ringof/TAPRx888/TAPRX-888 Review-4.pdf

# TAPRX-888

## Table of Contents

## Design Goals:

A simplified SDR, based on the RX-888:
- Proof-of-concept design
- HF-only, no VHF converter
- Larger PCB, 6-layer
- No bottom-side components
- 0603 passive components
- Improved thermal layout
- Improved RF input filter (bypassable)
- External reference clock input, auto-switching
- Attenuated filter-bypass injector port (used for timesync)
New-888 Design Documentation | ver 3 | 1

## Block Diagram:

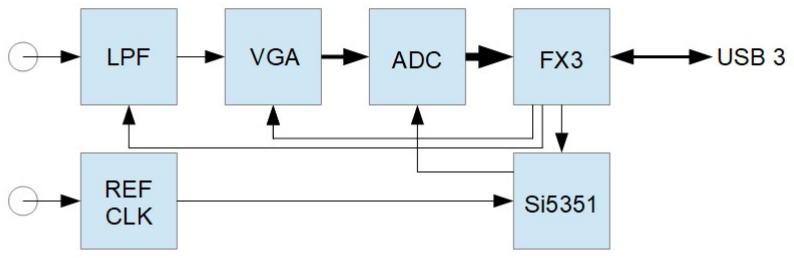
[picture p1: figure]

Block Details: (please see the accompanying schematic,

## provided in .pdf format)

Low Pass Filter
The existing RX-888 has a demonstrably poor input filter so this design includes an improved multi-section elliptical input filter combined with a high-pass shelf filter. There is a single 50 Ohm SMA input jack. While a balanced input is probably a desirable option, in the sake of simplicity I have decided to use an unbalanced design. With the shelf filter bypassed, this filter provides low-frequency response roll off at about 30 KHz.
The overall low freq cutoff is also affected by coupling caps at the VGA input and output. These can be changed in value if desired.
Some RX-888 users have requested that there be no input filtering at all, allowing them to operate in aliasing mode using external filters. To facilitate this, both the shelf and the low-pass filters can be bypassed using header-pin jumpers.
There is an SMA input jack that feeds the output of the filters with an attenuated signal. This can be used as a time-sync input.

Variable Gain Amplifier
The existing RX-888 has a coupling transformer that provides a balanced input to the VGA, and provides a 1:2 impedance step-up to match the filter to the 200 Ohm amplifier input impedance. The existing RX-888 also includes a variable attenuator and RF source multiplexers. In order to provide extended low frequency response, the new design eliminates these multiplexers and the transformer, instead driving the amplifier from a single-ended 50 Ohm source. This will reduce the overall gain, but elimination of the multiplexers will partially mitigate this.

Analog to Digital Converter
The board is designed to use the LTC2208 16-bit ADC (as is used in the RX-888), but the pin-compatible 14-bit variant can be used instead.
The analog input is provided by the differential output of the VGA, with minimal filtering.
The sample clock is provided by the Si5351 clock generator followed by a differential output buffer A future option to explore is to invert one of the unused outputs of the Si5351 to create a differential clock. Very accurate phase-control is available in this mode.

Clocks

Reference Clock Input
While the RX-888 typically uses a 27 MHz reference clock (and this is the fall-back frequency provided by the internal TCXO), in some cases a different frequency is used. The reference clock input allows virtually any frequency to be used.
This is a well-protected and properly-terminated clock input circuit, accepting a sine or square-wave input from 10 to 30 MHz (the reasonable limits of the internal Si5351 clock generator), with an amplitude range between -20 to +20 dBm. A clock-presence detector circuit automatically switches between the internal 27 MHz TCXO and the external clock. The clock detector status is available to be read by the FX3 firmware.
The clock-switching section may be modified to allow software control as well as automatic operation. A clock-status LED will probably be added.

Si5351 Clock Generator
(see “Analog to Digital Converter” for details)

FX3 USB Interface
AKA U9, the CYUSB3014
Much of the connections to this chip are based on Franco's extremely helpful email, excerpted below:

Also my repo for the FX3 firmware is just a copy of the original repo that Oscar Steila started and now Howard sort of maintains (his last commit was about six months ago): https://github.com/ik1xpv/ExtIO_sddc

Anyway the connections between the FX3 and the other peripherals are described in the so called IOMatrix: https://github.com/ik1xpv/ExtIO_sddc/blob/master/SDDC_FX3/StartUP.c#L63-L78

Translating that to English, it means that the FX3 uses:
- the UART port
- the I2C port
- the GPIF II interface in 16-bit mode (since that's how it pulls the samples the LTC2208)
- several GPIO pins (see below)
- the 'Low Performance Peripherals' (lpp) mode is set to CY_U3P_IO_MATRIX_LPP_UART_ONLY

With this information the next step is to look at datasheet of the FX3 (https://www.infineon.com/assets/row/public/documents/24/49/infineon-cyusb301x-cyusb201x-ez-usb-fx3-superspeed-usb-controller-datasheet-en.pdf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) (https://www.infineon.com/assets/row/public/documents/24/49/infineon-cyusb301x-cyusb201x-ez-usb-fx3-superspeed-usb-controller-datasheet-en.pdf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) on pages 28-31 where they have the pin description.
The column for 'CY_U3P_IO_MATRIX_LPP_UART_ONLY' is the one labelled '16-bit DataBus + UART + GPIO', which means that:
- UART uses pins D4, C1, C2, and D5
- I2C uses pins D9, and D10
- GPIF II (i.e. the LTC2208) uses pins F10, F9, F7, G10, G9, F8, H10, H9, J10, J9, K11, L10, K10, K9, J8, and G8
- the clock from the LTC2208 that is used to drive the GPIF II state machine is PCLK, which is on pin J6

As I mentioned above, there are also several GPIO pins being used in the RX888-mkII (https://github.com/ik1xpv/ExtIO_sddc/blob/master/SDDC_FX3/radio/rx888r2.c#L4-L15):

- GPIO_ATT_LE GPIO17 -> pin K8
- GPIO_BIAS_VHF GPIO18 -> pin K7
- GPIO_BIAS_HF GPIO19 -> pin J7
- GPIO_RANDO GPIO20 -> pin H7
- GPIO_LED_RED GPIO21 -> pin G7
- GPIO_PGA GPIO24 -> pin H8
- GPIO_ATT_DATA GPIO26 -> pin H6
- GPIO_ATT_CLK GPIO27 -> pin K5
- GPIO_SHDWN | GPIO28 -> pin J5
- GPIO_DITH | GPIO29 -> pin H5

- GPIO_VHF_EN GPIO35 -> pin K1
- GPIO_VGA_LE GPIO38 -> pin J1

GPIO[15:0]: connected to ADC DA[15:0]. While series resistors have been used on some versions of the “888” I believe that these were only necessary when the FX3 evaluation board was used. In the current design these traces are short and direct.
GPIO[16]: ADC CLKOUTA
GPIO[17]: external reference clock present (active high)
GPIO[35]: external clock select (active high) – previously used for GPIO_VHF_EN GPIO[37]: external clock auto-select (active low, remove R49 to force auto-select) GPIO[20]: ADC RAND (input to ADC)
GPIO[25]: ADC OVFL
GPIO[26]: VGA D (gain control data input to VGA)
GPIO[27]: VGA CLK
GPIO[38]: VGA Latch Enable
GPIO[29]:ADC Dither (probably not used)
GPIO[30]: PMODE[0] (selects USB boot mode, 0 Ohm pullup)
GPIO[31]: PMODE[1] (selects USB boot mode, 0 Ohm pullup)
GPIO[32]: PMODE[2] (selects USB boot mode, not connected resistor pullup) GPIO[33]: ID[0] 1K pulldown
GPIO[36]: ID[1] 1K pulldown
GPIO[45]: ID[2] 1K pulldown
GPIO[50]: ID[3] 1K pulldown
GPIO[51]: ID[4] 1K pulldown
GPIO[52]: ID[5] 1K LED pullup (blue, active low)
GPIO[53]: ID[6] 1K LED pullup (green, active low)
GPIO[54]: ID[7] 1K LED pullup (red, active low)
- Pad C5 is the RESET_N input, currently connected to a simple RC pullup and puchbutton. In a future revision this may be changed to a slower and more reliable erset circuit.
- Pad C6 (XTALIN) is being driven by a 19.2 MHz oscillator, rather than with a crystal and load capacitors. This is done to avoid potential crystal and tuning issues. This may be changed in a future revision.

- The ID[7:0] nets are used to identify the TAPRX-888 board to the FX3 firmwareFrom “ExtIO_sddc-master:”

HWSDRtable.h v1.2
Hardware detection of BBRF103 family SDRs
+--------------+-------+------+------+------+------+------+------+------+------+----------------------------+
| SDR | | MODEL | GPIO | GPIO | GPIO | GPIO | GPIO | GPIO | GPIO | GPIO | USED BY | |
| | | # | | 33 | | 36 | | 45 | | 50 | | 51 | | 52 | | 53 | | 54 | | | |
+--------------+-------+------+------+------+------+------+------+------+------+----------------------------+
| BBRF103 | | 0x01 | | - | | - | | - | pd* | | - | | - | | - | LED | Oscar Steila | |
+--------------+-------+------+------+------+------+------+------+------+------+----------------------------+
| HF103 | | 0x02 | | - | | - | | - | | - | pd* | | - | | - | LED | Oscar Steila | |
+--------------+-------+------+------+------+------+------+------+------+------+----------------------------+
| RX888 | | 0x03 | | - | | - | pd | | - | | - | | - | | - | | - | Justin Peng / Howard Su | |
+--------------+-------+------+------+------+------+------+------+------+------+----------------------------+
| RX888 r2 | | 0x04 | | - | pd | | - | | - | | - | | - | | - | | - | Justin Peng / Howard Su | |
+--------------+-------+------+------+------+------+------+------+------+------+----------------------------+
| RX999 | | 0x05 | pd | | - | | - | | - | | - | | - | | - | | - | Justin Peng / Howard Su | |
+--------------+-------+------+------+------+------+------+------+------+------+----------------------------+
| LUCY | | 0x06 | | - | | - | | - | | - | | - | pd+ | pd+ | | - | Wiktor Starzak | |
+--------------+-------+------+------+------+------+------+------+------+------+----------------------------+
| --- | | - | | | - | | - | | - | pd | pd | pd | pd | LED | Oscar Steila | |
+--------------+-------+------+------+------+------+------+------+------+------+----------------------------+
| SDR-HF | | - | | | - | | - | | - | pu | pd | pd | pd | LED | Pieter Ibelings | |
+--------------+-------+------+------+------+------+------+------+------+------+----------------------------+
+--------------+-------+------+------+------+------+------+------+------+------+----------------------------+

Power Supply
The board is powered from the USB-3 port, drawing approximately 1A at 5V.
There are three principal regulated voltage domains: 1.25V for the FX3 core, 3.3V for the FX3 I/O, and 3.3V for the ADC. In addition, the VGA and the clock section each have 3.3V supplied by individual regulators.
The FX3 and ADC 3.3V sources are fed by individual regulators, but the regulator outputs are clamped together by two Schottky diodes to ensure that these outputs start up together. A single regulator can provide the initial current, but dual regulators are used to distribute the thermal dissipation.
The 1.25V regulator is connected to a 3.3V pre-regulator, again to distribute the thermal dissipation.

Regulator Power Dissipation

3V3REF

Device | Current | Regulator Dissipation (5V – 3.3V) * I
Clock Block | 60 mA | 102 mW

VGA3.3V

Device | Current | Regulator Dissipation (5V – 3.3V) * I
AD8370 VGA | 100 mA | 170 mW

+3V3ADC

Device | Current | Regulator Dissipation (5V – 3.3V) * I
LTC2208 ADC Ivdd | 100 mA | 170 mW
LTC2208 ADC IOvdd | 450 mA | 765 mW
total | 550 mA | 935 mW

+3V3

Device | Current | Regulator Dissipation (5V – 3.3V) * I
U8 19.2MHz XO | 5 mA | 9 mW
U9 CYUSB3014 IO | 10 mA ? | 17 mW
total | 15 mA ? | 26 mW

+1V2

Device | Current | Power
U9 CYUSB3014 core | 200 mA
U9 CYUSB3014 USB | 60 mA
total | 260 mA | Regulator Dissipation
Pre-regulator (3.3V) | | 442 mW
Post-regulator (1.25V) | | 533 mW

Total board power: 985mA x 5V = approximately 5W

## Layout

This is a six-layer board, with all components on the top. The board is 76mm wide, 100mm long. The layers are:
Top | Signal and power traces
2 | Ground
3 | Power planes
4 | Signal + ground + 1.2V Power
5 | Ground
Bottom | Signal + ground

Top

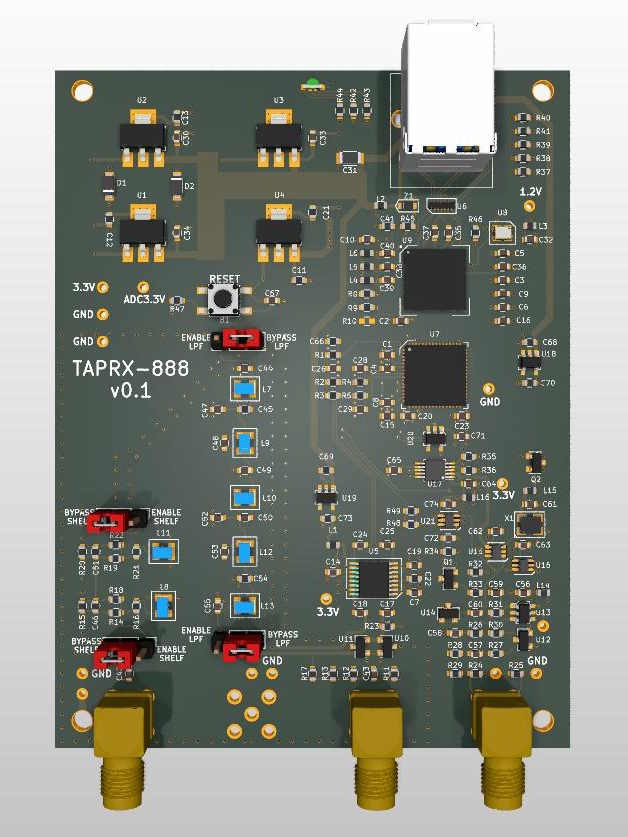
[picture p2: figure]

Bottom
The components with significant thermal dissipation have copper zones on all layers, interconnected by thermal vias. The bottom-side solder-mask is absent around these zones, allowing for the use of a thermal pad to transfer the heat to the aluminum enclosure. The four un-masked areas underneath the voltage regulators are electrically connected to the various positive regulator outputs, while the areas under the VGA and the ADC are at ground potential.

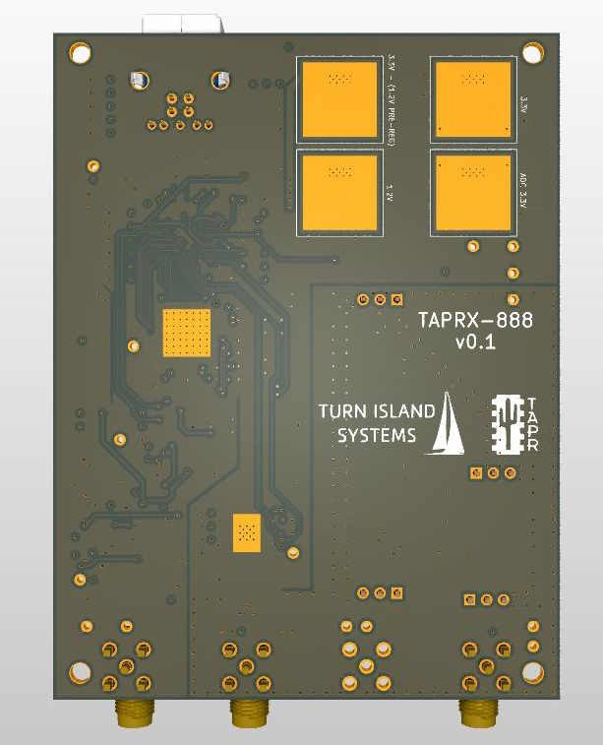
[picture p3: figure]

Ground Planes
The ground and power planes have isolation gaps (seen here on the layer-2 groundplane) that are intended to reduce ground-path current induced inter-stage coupling.

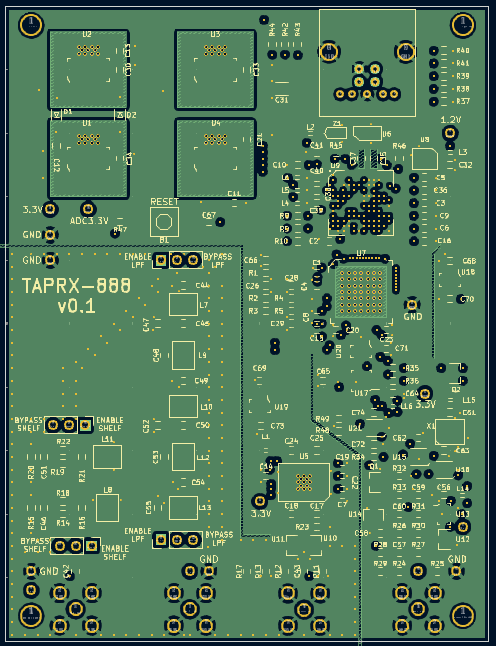
[picture p4: figure]

Power Plane

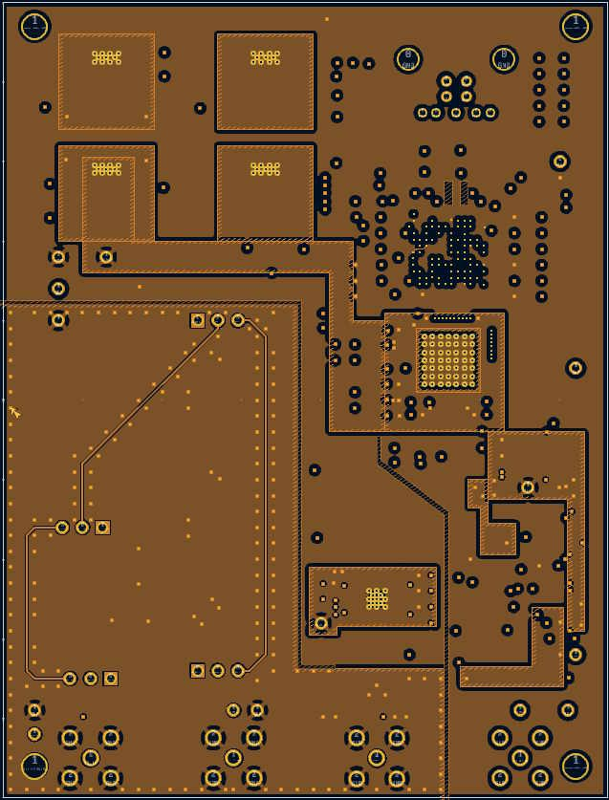
[picture p5: figure]

The layer 3 power plane distributes the various +3.3V supplies, with some isolated sections that provide additional filtering.
In the area of the RF input filters this layer is used as additional groundplane and signal routing. The +1.2V supply is distributed on layer 4.

## Cost

This is just a rough estimate, not to be trusted.

JLCPCB fab/assy, qty 5

Missing parts, +$177:

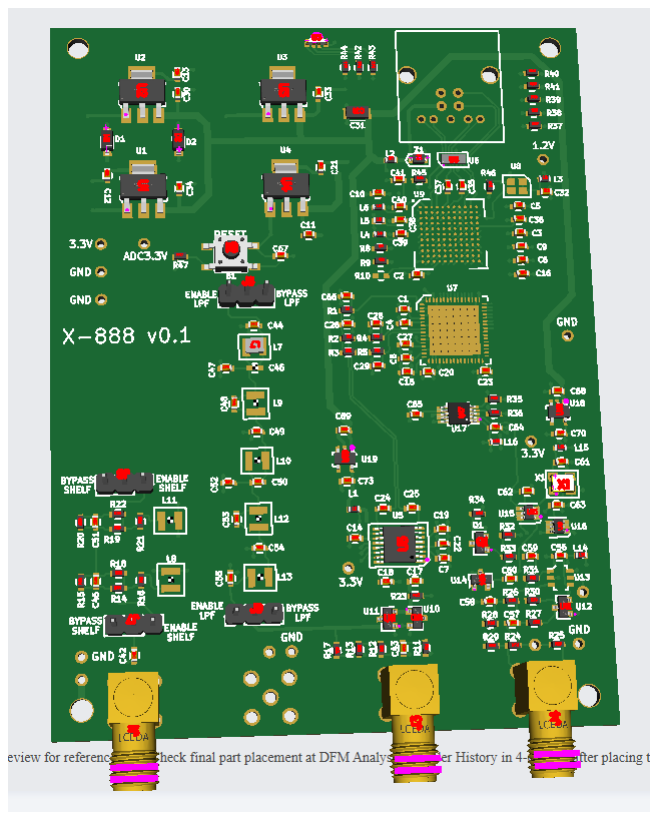
[picture p6: figure]
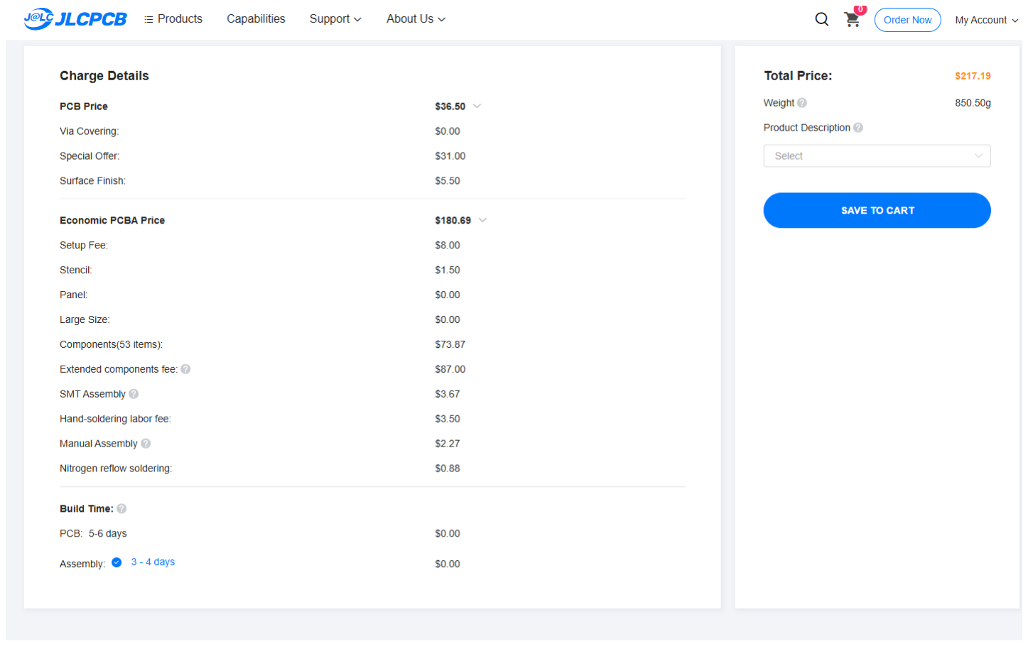
[picture p7: figure]

LTC2208 ADC: $150 (qty 10, Mouser) – 14-bit parts cost about the same CYUSB3014-BZXCT: $25 (qty 10, DigiKey)
TLV3501 (comparator): $1.20 (qty 10, LCSC)
USB-306BWD-ARW (USB 3.0 connector): $0.41 (qty 10, LCSC)

Oscillator-19.2MHz: $0.33 (qty 10, LCSC)

JLC fab+assy cost, plus missing parts = approx $400 add:
12% sales tax: $48
50% customs / tariff: $200
Shipping: $150

Total: $798
About $160 per board, probably more.

The enclosure I use costs about $7 (including custom PCB faceplates). External heatsink: $?
Thermal pad: $?
Testing: $?
