ringof/TAPRx888/TAPRX-888.kicad_pcb

## KiCad design TAPRX-888.kicad_pcb (2026-07-15)

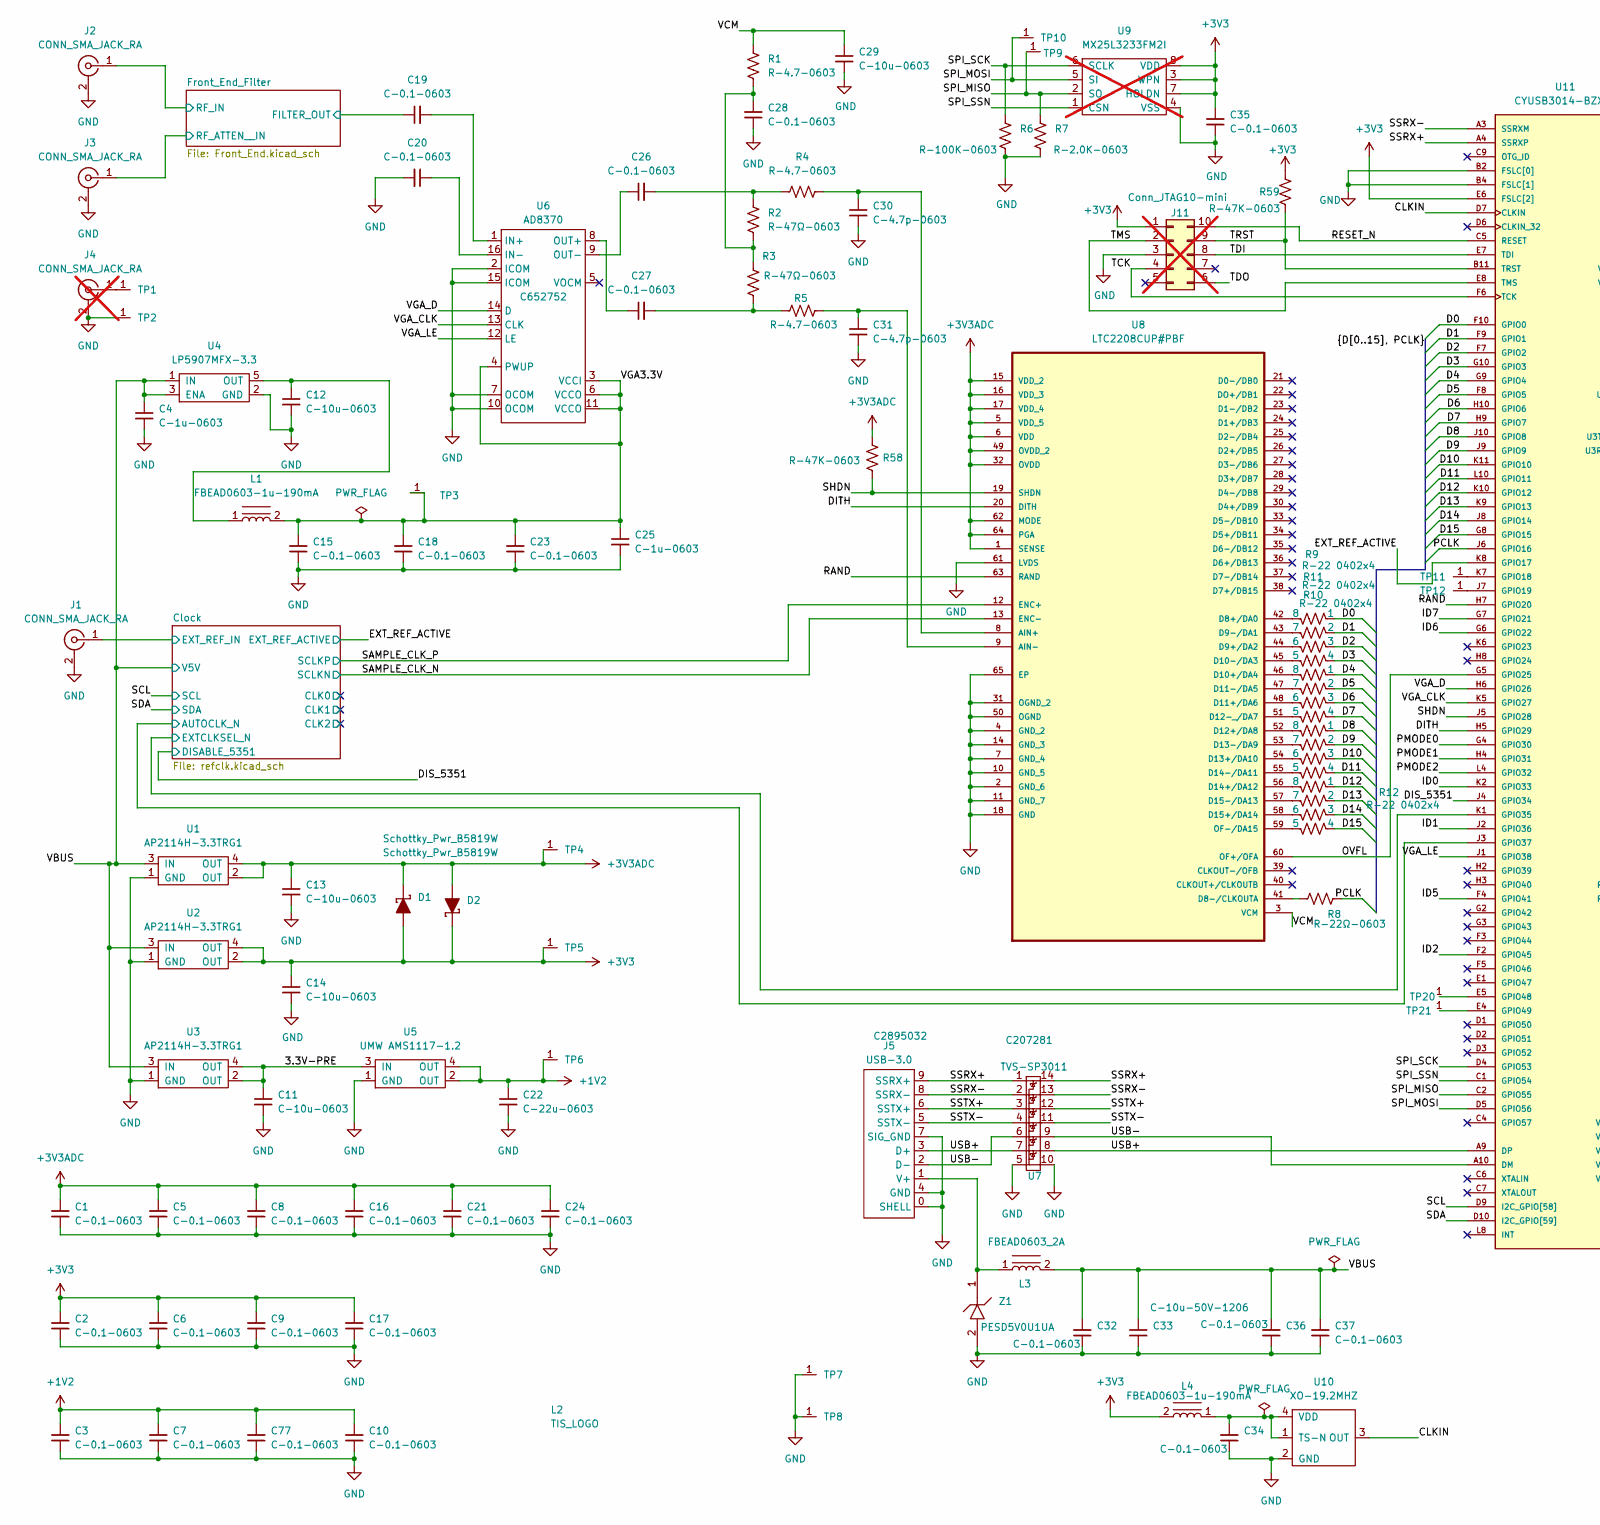
[picture p8: schematic TAPRX-888.kicad_sch, part in row 1, column 1]

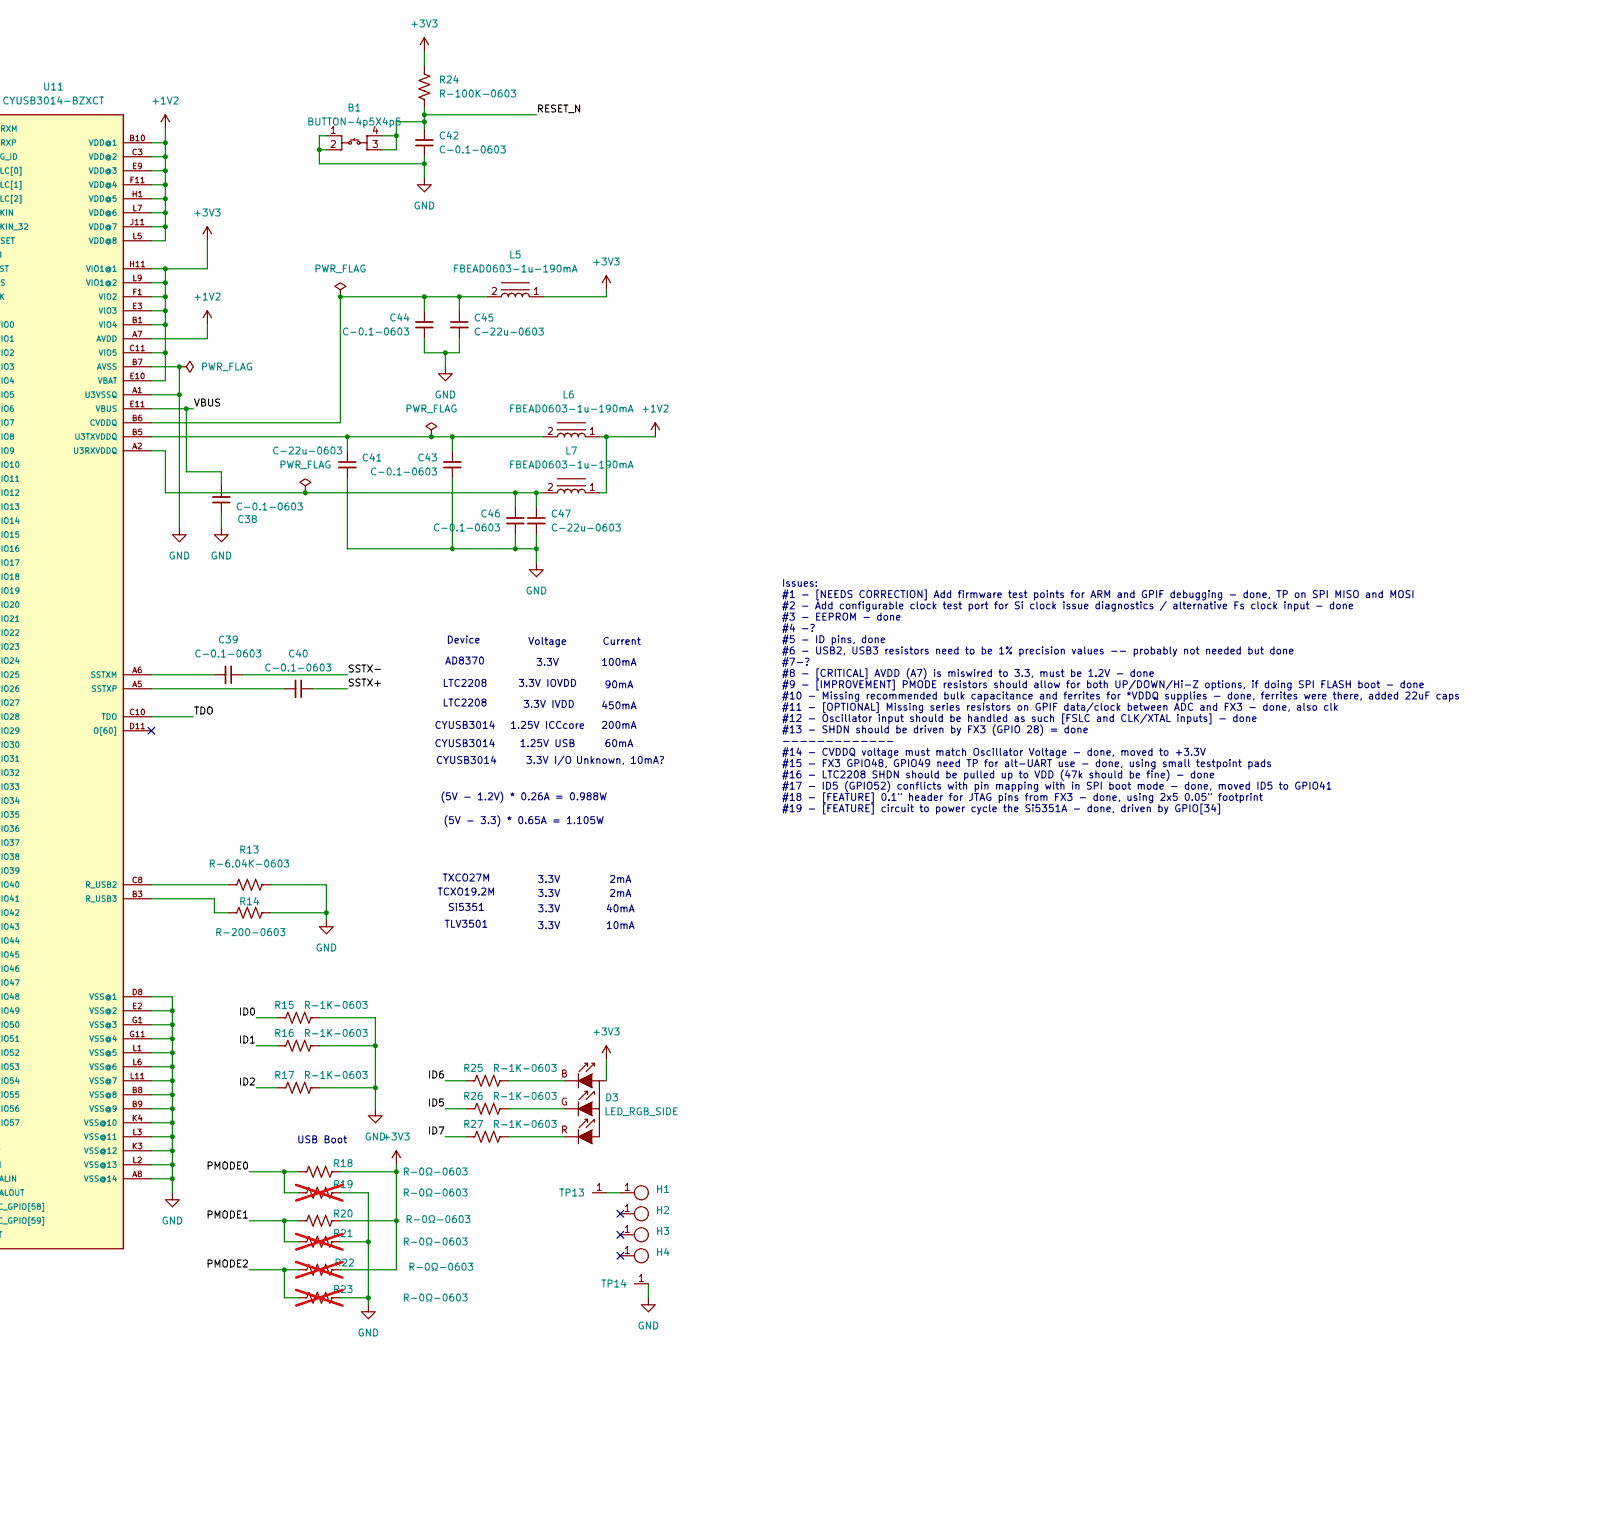
[picture p9: schematic TAPRX-888.kicad_sch, part in row 1, column 2]

Parts:
B1: BUTTON-4p5X4p5; LCSC Part # C410371
C1, C2, C3, C5, C6, C7, C8, C9, C10, C15, C16, C17, C18, C19, C20, C21, C23, C24, C26, C27, C28, C32, C34, C35, C36, C37, C38, C39, C40, C42, C43, C44, C46, C77: C-0.1-0603; C_0603; LCSC Part # C14663
C4, C25: C-1u-0603; PAD_0603; LCSC Part # C15849
C11, C12, C13, C14, C29: C-10u-0603; PAD_0603; LCSC Part # C96446
C22, C41, C45, C47: C-22u-0603; PAD_0603; LCSC Part # C59461
C30, C31: C-4.7p-0603; C_0603; LCSC Part # C1669
C33: C-10u-50V-1206; PAD_1206; LCSC Part # C13585
D1, D2: Schottky_Pwr_B5819W; SOD-123; LCSC Part # C8598
D3: LED_RGB_SIDE; LCSC Part # C389528
H1, H2, H3, H4: MountingHole_M2.5-PTH
J1, J2, J3: CONN_SMA_JACK_RA; SMA-RA-Jack; LCSC Part # C91455
J4: CONN_SMA_JACK_RA; SMA-RA-Jack; LCSC Part # C91455; not fitted
J5: USB-3.0; LCSC Part # C2895032
J11: Conn_JTAG10-mini; CONN-JTAG10-mini; LCSC Part # Cxxxxxx; not fitted
L1, L4, L5, L6, L7: FBEAD0603-1u-190mA; 0603; LCSC Part # C307748
L2: TIS_LOGO; TIS-Logo
L3: FBEAD0603_2A; 0603; LCSC Part # C14709
R1, R4, R5: R-4.7-0603; PAD_0603; LCSC Part # C23164
R2, R3: R-47Ω-0603; PAD_0603; LCSC Part # C23179
R6, R24: R-100K-0603; PAD_0603; LCSC Part # C25803
R7: R-2.0K-0603; PAD_0603; LCSC Part # C22975
R8: R-22Ω-0603; PAD_0603; LCSC Part # C23345
R9, R10, R11, R12: R-22 0402x4; 4D02; LCSC Part # C25499
R13: R-6.04K-0603; PAD_0603; LCSC Part # C25977
R14: R-200-0603; PAD_0603; LCSC Part # C8218
R15, R16, R17, R25, R26, R27: R-1K-0603; PAD_0603; LCSC Part # C21190
R18, R20: R-0Ω-0603; PAD_0603; LCSC Part # C21189
R19, R21, R22, R23: R-0Ω-0603; PAD_0603; LCSC Part # C21189; not fitted
R58, R59: R-47K-0603; PAD_0603; LCSC Part # C25819
TP1, TP2, TP3, TP4, TP5, TP6, TP7, TP8, TP9, TP10, TP11, TP12, TP13, TP14: TP
TP20, TP21: TP-TINY; TP-Tiny
U1, U2, U3: AP2114H-3.3TRG1; SOT-223_THERMAL; LCSC Part # C150716
U4: LP5907MFX-3.3; SOT-23-5; LCSC Part # C80670
U5: UMW AMS1117-1.2; SOT-223_THERMAL; LCSC Part # C347218
U6: AD8370; TSSOP-16-Thermal; LCSC Part # C652752
U7: TVS-SP3011; SP3011; LCSC Part # C207281
U8: LTC2208CUP#PBF; QFN-64_EP_9.5x9.5_Pitch0.5mm; MPN LTC2208CUP#PBF#PBF; LCSC Part # C7458386
U9: MX25L3233FM2I; SOIC-8-dual; LCSC Part # C190802; not fitted
U10: XO-19.2MHZ; SMD-2520; LCSC Part # C49304731
U11: CYUSB3014-BZXCT; BGA-121; DigiKey_Part_Number 448-CYUSB3014-BZXCTTR-ND
Z1: PESD5V0U1UA; SOD-323; LCSC Part # C5380401

Connections:
+1V2: C3.2, C7.2, C10.2, C22.1, C77.2, L6.1, L7.1, TP6.1, U5.2 (OUT), U5.4 (OUT), U11.A7 (AVDD), U11.B10 (VDD@1), U11.C3 (VDD@2), U11.E9 (VDD@3), U11.F11 (VDD@4), U11.H1 (VDD@5), U11.J11 (VDD@7), U11.L5 (VDD@8), U11.L7 (VDD@6)
+3V3: C2.2, C6.2, C9.2, C14.1, C17.2, C35.2, D1.2 (A), D2.1 (K), D3.1 (C), J11.1, L4.2, L5.1, R18.2, R20.2, R22.2, R24.1, R59.1, TP5.1, U2.2 (OUT), U2.4 (OUT), U9.3 (WPN), U9.7 (HOLDN), U9.8 (VDD), U11.B1 (VIO4), U11.C11 (VIO5), U11.E3 (VIO3), U11.E6 (FSLC[2]), U11.E10 (VBAT), U11.F1 (VIO2), U11.H11 (VIO1@1), U11.L9 (VIO1@2); also elsewhere on the board
+3V3ADC: C1.2, C5.2, C8.2, C13.1, C16.2, C21.2, C24.2, D1.1 (K), D2.2 (A), R58.1, TP4.1, U1.2 (OUT), U1.4 (OUT), U8.1 (SENSE), U8.5 (VDD_5), U8.6 (VDD), U8.15 (VDD_2), U8.16 (VDD_3), U8.17 (VDD_4), U8.32 (OVDD), U8.49 (OVDD_2), U8.62 (MODE), U8.64 (PGA)
/3.3V-PRE: C11.1, U3.2 (OUT), U3.4 (OUT), U5.3 (IN)
/CLKIN: U10.3 (OUT), U11.D7 (CLKIN)
/Clock/AUTOCLK_N: U11.J3 (GPIO37); also elsewhere on the board
/Clock/EXTCLKSEL_N: U11.K1 (GPIO35); also elsewhere on the board
/Clock/EXT_REF_IN: J1.1 (In); also elsewhere on the board
/D0: R9.1, U11.F10 (GPIO0)
/D1: R9.2, U11.F9 (GPIO1)
/D2: R9.3, U11.F7 (GPIO2)
/D3: R9.4, U11.G10 (GPIO3)
/D4: R10.1, U11.G9 (GPIO4)
/D5: R10.2, U11.F8 (GPIO5)
/D6: R10.3, U11.H10 (GPIO6)
/D7: R10.4, U11.H9 (GPIO7)
/D8: R11.1, U11.J10 (GPIO8)
/D9: R11.2, U11.J9 (GPIO9)
/D10: R11.3, U11.K11 (GPIO10)
/D11: R11.4, U11.L10 (GPIO11)
/D12: R12.1, U11.K10 (GPIO12)
/D13: R12.2, U11.K9 (GPIO13)
/D14: R12.3, U11.J8 (GPIO14)
/D15: R12.4, U11.G8 (GPIO15)
/DIS_5351: U11.J4 (GPIO34); also elsewhere on the board
/DITH: U8.20 (DITH), U11.H5 (GPIO29)
/EXT_REF_ACTIVE: U11.K8 (GPIO17); also elsewhere on the board
/Front_End_Filter/FILTER_OUT: C19.1; also elsewhere on the board
/Front_End_Filter/RF_ATTEN__IN: J3.1 (In); also elsewhere on the board
/Front_End_Filter/RF_IN: J2.1 (In); also elsewhere on the board
/ID0: R15.1, U11.K2 (GPIO33)
/ID1: R16.1, U11.J2 (GPIO36)
/ID2: R17.1, U11.F2 (GPIO45)
/ID5: R26.1, U11.F4 (GPIO41)
/ID6: R25.1, U11.G6 (GPIO22)
/ID7: R27.1, U11.G7 (GPIO21)
/OVFL: U8.60 (OF+/OFA), U11.G5 (GPIO25)
/PCLK: R8.2, U11.J6 (GPIO16)
/PMODE0: R18.1, R19.1, U11.G4 (GPIO30)
/PMODE1: R20.1, R21.1, U11.H4 (GPIO31)
/PMODE2: R22.1, R23.1, U11.L4 (GPIO32)
/RAND: U8.63 (RAND), U11.H7 (GPIO20)
/RESET_N: B1.3, B1.4, C42.2, J11.10, R24.2, U11.C5 (RESET)
/SAMPLE_CLK_N: U8.13 (ENC-); also elsewhere on the board
/SAMPLE_CLK_P: U8.12 (ENC+); also elsewhere on the board
/SCL: U11.D9 (I2C_GPIO[58]); also elsewhere on the board
/SDA: U11.D10 (I2C_GPIO[59]); also elsewhere on the board
/SHDN: R58.2, U8.19 (SHDN), U11.J5 (GPIO28)
/SPI_MISO: R7.1, TP9.1, U9.2 (SO), U11.C2 (GPIO55)
/SPI_MOSI: TP10.1, U9.5 (SI), U11.D5 (GPIO56)
/SPI_SCK: R6.1, U9.6 (SCLK), U11.D4 (GPIO53)
/SPI_SSN: U9.1 (CSN), U11.C1 (GPIO54)
/SSRX+: J5.9 (SSRX+), U7.1, U7.14, U11.A4 (SSRXP)
/SSRX-: J5.8 (SSRX-), U7.2, U7.13, U11.A3 (SSRXM)
/SSTX+: C40.1, J5.6 (SSTX+), U7.3, U7.12
/SSTX-: C39.1, J5.5 (SSTX-), U7.4, U7.11
/TCK: J11.4, U11.F6 (TCK)
/TDI: J11.8, U11.E7 (TDI)
/TDO: J11.6, U11.C10 (TDO)
/TMS: J11.2, U11.E8 (TMS)
/TRST: J11.9, R59.2, U11.B11 (TRST)
/USB+: J5.3 (D+), U7.7, U7.8, U11.A9 (DP)
/USB-: J5.2 (D-), U7.6, U7.9, U11.A10 (DM)
/VBUS: C4.1, C32.2, C33.1, C36.2, C37.2, C38.2, L3.2, U1.3 (IN), U2.3 (IN), U3.3 (IN), U4.1 (IN), U4.3 (ENA), U11.E11 (VBUS); also elsewhere on the board
/VCM: C29.1, R1.1, U8.3 (VCM)
/VGA3.3V: C15.2, C18.2, C23.2, C25.1, L1.2, TP3.1, U6.3 (VCCI), U6.4 (PWUP), U6.6 (VCCO), U6.11 (VCCO)
/VGA_CLK: U6.13 (CLK), U11.K5 (GPIO27)
/VGA_D: U6.14 (D), U11.H6 (GPIO26)
/VGA_LE: U6.12 (LE), U11.J1 (GPIO38)
GND: B1.1, B1.2, C1.1, C2.1, C3.1, C4.2, C5.1, C6.1, C7.1, C8.1, C9.1, C10.1, C11.2, C12.2, C13.2, C14.2, C15.1, C16.1, C17.1, C18.1, C20.2, C21.1, C22.2, C23.1, C24.1, C25.2, C28.1, C29.2, C30.2, C31.2, C32.1, C33.2, C34.1, C35.1, C36.1, C37.1, C38.1, C41.2, C42.1, C43.1, C44.1, C45.2, C46.1, C47.2, C77.1, J1.2 (Ext), J2.2 (Ext), J3.2 (Ext), J4.2 (Ext), J5.0 (SHELL), J5.4 (GND), J5.7 (SIG_GND), J11.3, R6.2, R7.2, R13.2, R14.2, R15.2, R16.2, R17.2, R19.2, R21.2, R23.2, TP2.1, TP7.1, TP8.1, TP14.1, U1.1 (GND), U2.1 (GND), U3.1 (GND), U4.2 (GND), U5.1 (GND), U6.2 (ICOM), U6.7 (OCOM), U6.10 (OCOM), U6.15 (ICOM), U7.5, U7.10, U8.2 (GND_6), U8.4 (GND_2), U8.7 (GND_4), U8.10 (GND_5), U8.11 (GND_7), U8.14 (GND_3), U8.18 (GND), U8.31 (OGND_2), U8.50 (OGND), U8.61 (LVDS), U8.65 (EP), U9.4 (VSS), U10.2 (GND), U11.A1 (U3VSSQ), U11.A8 (VSS@14), U11.B2 (FSLC[0]), U11.B4 (FSLC[1]), U11.B7 (AVSS), U11.B8 (VSS@8), U11.B9 (VSS@9), U11.D8 (VSS@1), U11.E2 (VSS@2), U11.G1 (VSS@3), U11.G11 (VSS@4), U11.K3 (VSS@12), U11.K4 (VSS@10), U11.L1 (VSS@5), U11.L2 (VSS@13), U11.L3 (VSS@11), U11.L6 (VSS@6), U11.L11 (VSS@7), Z1.2; also elsewhere on the board
unnamed: C26.2, R2.1, R4.1
unnamed: C27.2, R3.2, R5.1
unnamed: C28.2, R1.2, R2.2, R3.1
unnamed: D3.2 (B), R25.2
unnamed: D3.3 (G), R26.2
unnamed: D3.4 (R), R27.2
unnamed: H1.1, TP13.1
unnamed: J4.1 (In), TP1.1
unnamed: J5.1 (V+), L3.1, Z1.1
unnamed: C12.1, L1.1, U4.5 (OUT)
unnamed: C19.2, U6.1 (IN+)
unnamed: C20.1, U6.16 (IN-)
unnamed: C27.1, U6.8 (OUT+)
unnamed: C26.1, U6.9 (OUT-)
unnamed: C30.1, R4.2, U8.8 (AIN+)
unnamed: C31.1, R5.2, U8.9 (AIN-)
unnamed: R9.8, U8.42 (D8+/DA0)
unnamed: R8.1, U8.41 (D8-/CLKOUTA)
unnamed: R9.6, U8.44 (D9+/DA2)
unnamed: R9.7, U8.43 (D9-/DA1)
unnamed: R10.8, U8.46 (D10+/DA4)
unnamed: R9.5, U8.45 (D10-/DA3)
unnamed: R10.6, U8.48 (D11+/DA6)
unnamed: R10.7, U8.47 (D11-/DA5)
unnamed: R11.8, U8.52 (D12+/DA8)
unnamed: R10.5, U8.51 (D12-_/DA7)
unnamed: R11.6, U8.54 (D13+/DA10)
unnamed: R11.7, U8.53 (D13-/DA9)
unnamed: R12.8, U8.56 (D14+/DA12)
unnamed: R11.5, U8.55 (D14-/DA11)
unnamed: R12.6, U8.58 (D15+/DA14)
unnamed: R12.7, U8.57 (D15-/DA13)
unnamed: R12.5, U8.59 (OF-/DA15)
unnamed: C34.2, L4.1, U10.1 (TS-N), U10.4 (VDD)
unnamed: C44.2, C45.1, L5.2, U11.B6 (CVDDQ)
unnamed: TP11.1, U11.K7 (GPIO18)
unnamed: TP12.1, U11.J7 (GPIO19)
unnamed: TP20.1, U11.E5 (GPIO48)
unnamed: TP21.1, U11.E4 (GPIO49)
unnamed: R13.1, U11.C8 (R_USB2)
unnamed: R14.1, U11.B3 (R_USB3)
unnamed: C39.2, U11.A6 (SSTXM)
unnamed: C40.2, U11.A5 (SSTXP)
unnamed: C46.2, C47.1, L7.2, U11.A2 (U3RXVDDQ)
unnamed: C41.1, C43.2, L6.2, U11.B5 (U3TXVDDQ)

Notes on the sheet:
3.3V
CYUSB3014
TCXO19.2M
3.3V IOVDD
2mA
Issues: #1 - [NEEDS CORRECTION] Add firmware test points for ARM and GPIF debugging - done, TP on SPI MISO and MOSI #2 - Add configurable clock test port for Si clock issue diagnostics / alternative Fs clock input - done #3 - EEPROM - done #4 -? #5 - ID pins, done #6 - USB2, USB3 resistors need to 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
TXCO27M
1.25V USB
LTC2208
450mA
3.3V IVDD
200mA
10mA
100mA
Voltage
TLV3501
(5V - 3.3) * 0.65A = 1.105W
Si5351
USB Boot
90mA
1.25V ICCcore
Unknown, 10mA?
AD8370
40mA
60mA
Device
Current
3.3V I/O
(5V - 1.2V) * 0.26A = 0.988W

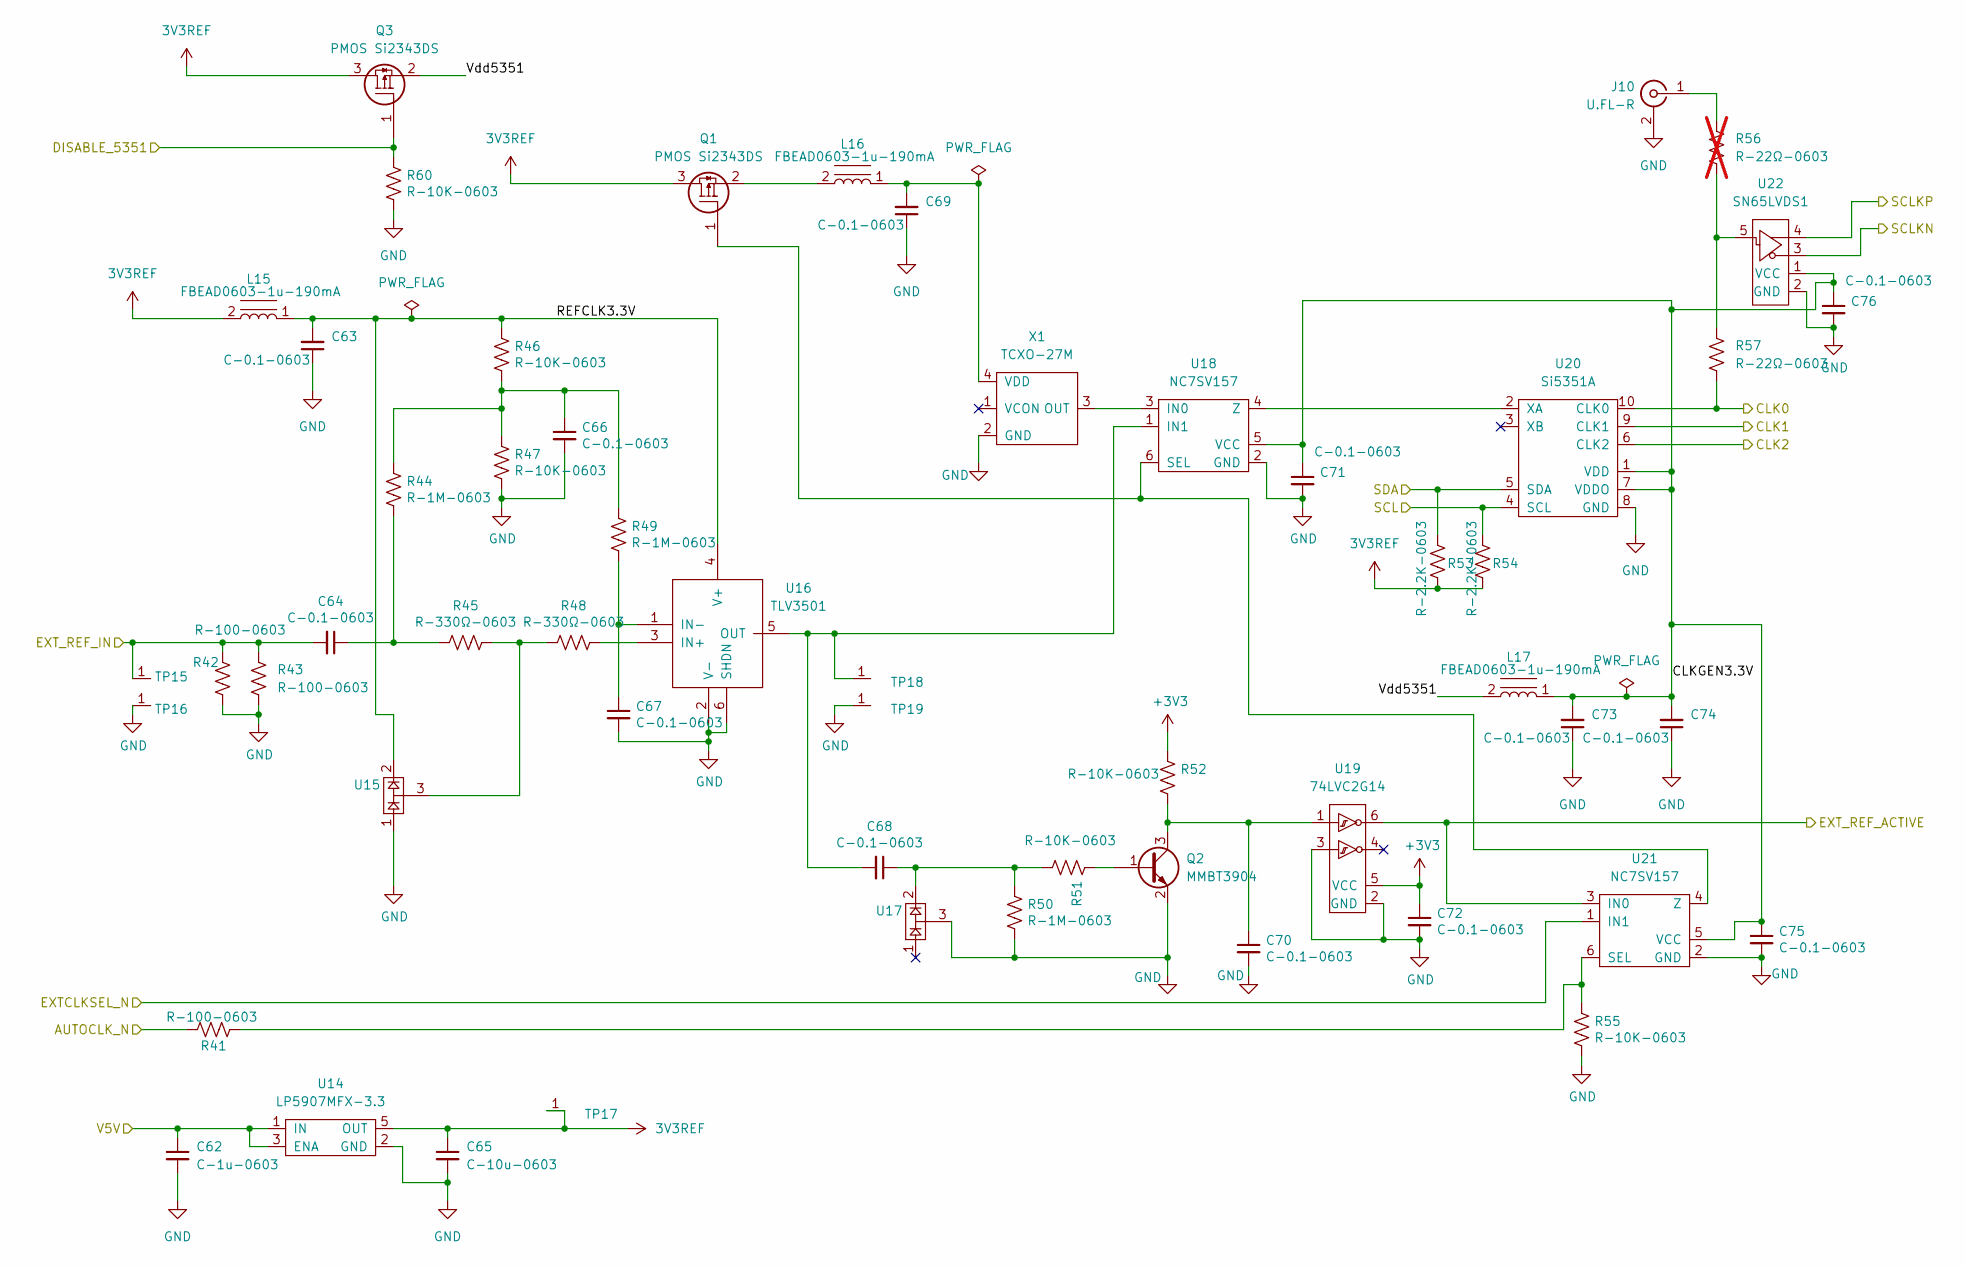
[picture p10: schematic refclk.kicad_sch]

Parts:
C62: C-1u-0603; PAD_0603; LCSC Part # C15849
C63, C64, C66, C67, C68, C69, C70, C71, C72, C73, C74, C75, C76: C-0.1-0603; C_0603; LCSC Part # C14663
C65: C-10u-0603; PAD_0603; LCSC Part # C96446
J10: U.FL-R; HRS_U.FL-R-SMT(01); LCSC Part # C88374
L15, L16, L17: FBEAD0603-1u-190mA; 0603; LCSC Part # C307748
Q1, Q3: PMOS Si2343DS; SOT-23; LCSC Part # C6903
Q2: MMBT3904; SOT-23; LCSC Part # C20526
R41, R42, R43: R-100-0603; PAD_0603; LCSC Part # C22775
R44, R49, R50: R-1M-0603; PAD_0603; LCSC Part # C22935
R45, R48: R-330Ω-0603; PAD_0603; LCSC Part # C23138
R46, R47, R51, R52, R55, R60: R-10K-0603; PAD_0603; LCSC Part # C25804
R53, R54: R-2.2K-0603; PAD_0603; LCSC Part # C4190
R56: R-22Ω-0603; PAD_0603; LCSC Part # C23345; not fitted
R57: R-22Ω-0603; PAD_0603; LCSC Part # C23345
TP15, TP16, TP17, TP18, TP19: TP
U14: LP5907MFX-3.3; SOT-23-5; LCSC Part # C80670
U15, U17: SOT-23; LCSC Part # C78088
U16: TLV3501; SOT-23-6; LCSC Part # C193413
U18, U21: NC7SV157; SC-70-6; LCSC Part # C184123
U19: 74LVC2G14; SC-70-6_rot90; LCSC Part # C19829575
U20: Si5351A; MSOP-10_W3mm; LCSC Part # C504891
U22: SN65LVDS1; SOT-23-5; LCSC Part # C465731
X1: TCXO-27M; TCXO-3225; LCSC Part # C5203549

Connections:
3V3REF: C65.1, L15.2, Q1.3 (D), Q3.3 (D), R53.2, R54.2, TP17.1, U14.5 (OUT)
+3V3: C72.1, R52.1, U19.5 (VCC); also elsewhere on the board
/Clock/AUTOCLK_N: R41.1; also elsewhere on the board
/Clock/CLK0: R57.2, U20.10 (CLK0)
/Clock/CLK1: U20.9 (CLK1)
/Clock/CLK2: U20.6 (CLK2)
/Clock/CLKGEN3.3V: C71.1, C73.2, C74.2, C75.1, C76.1, L17.1, U18.5 (VCC), U20.1 (VDD), U20.7 (VDDO), U21.5 (VCC), U22.1 (VCC)
/Clock/EXTCLKSEL_N: U21.1 (IN1); also elsewhere on the board
/Clock/EXT_REF_IN: C64.2, R42.1, R43.1, TP15.1; also elsewhere on the board
/Clock/REFCLK3.3V: C63.2, L15.1, R46.1, U15.2, U16.4 (V+)
/Clock/Vdd5351: L17.2, Q3.2 (S)
/DIS_5351: Q3.1 (G), R60.1; also elsewhere on the board
/EXT_REF_ACTIVE: U19.6, U21.3 (IN0); also elsewhere on the board
/SAMPLE_CLK_N: U22.3; also elsewhere on the board
/SAMPLE_CLK_P: U22.4; also elsewhere on the board
/SCL: R54.1, U20.4 (SCL); also elsewhere on the board
/SDA: R53.1, U20.5 (SDA); also elsewhere on the board
/VBUS: C62.1, U14.1 (IN), U14.3 (ENA); also elsewhere on the board
GND: C62.2, C63.1, C65.2, C66.2, C67.2, C69.1, C70.2, C71.2, C72.2, C73.1, C74.1, C75.2, C76.2, J10.2 (Ext), Q2.2 (E), R42.2, R43.2, R47.2, R50.2, R55.2, R60.2, TP16.1, TP19.1, U14.2 (GND), U15.1, U16.2 (V-), U16.6 (SHDN), U17.3, U18.2 (GND), U19.2 (GND), U19.3, U20.8 (GND), U21.2 (GND), U22.2 (GND), X1.2 (GND); also elsewhere on the board
unnamed: C64.1, R44.2, R45.2
unnamed: C66.1, R44.1, R46.2, R47.1, R49.1
unnamed: C68.1, R50.1, R51.2, U17.2
unnamed: J10.1 (In), R56.1
unnamed: Q1.1 (G), U18.6 (SEL), U21.4 (Z)
unnamed: L16.2, Q1.2 (S)
unnamed: Q2.1 (B), R51.1
unnamed: C70.1, Q2.3 (C), R52.2, U19.1
unnamed: R45.1, R48.2, U15.3
unnamed: R56.2, R57.1, U22.5
unnamed: R48.1, U16.3 (IN+)
unnamed: C67.1, R49.2, U16.1 (IN-)
unnamed: C68.2, TP18.1, U16.5 (OUT), U18.1 (IN1)
unnamed: U18.3 (IN0), X1.3 (OUT)
unnamed: U18.4 (Z), U20.2 (XA)
unnamed: R41.2, R55.1, U21.6 (SEL)
unnamed: C69.2, L16.1, X1.4 (VDD)

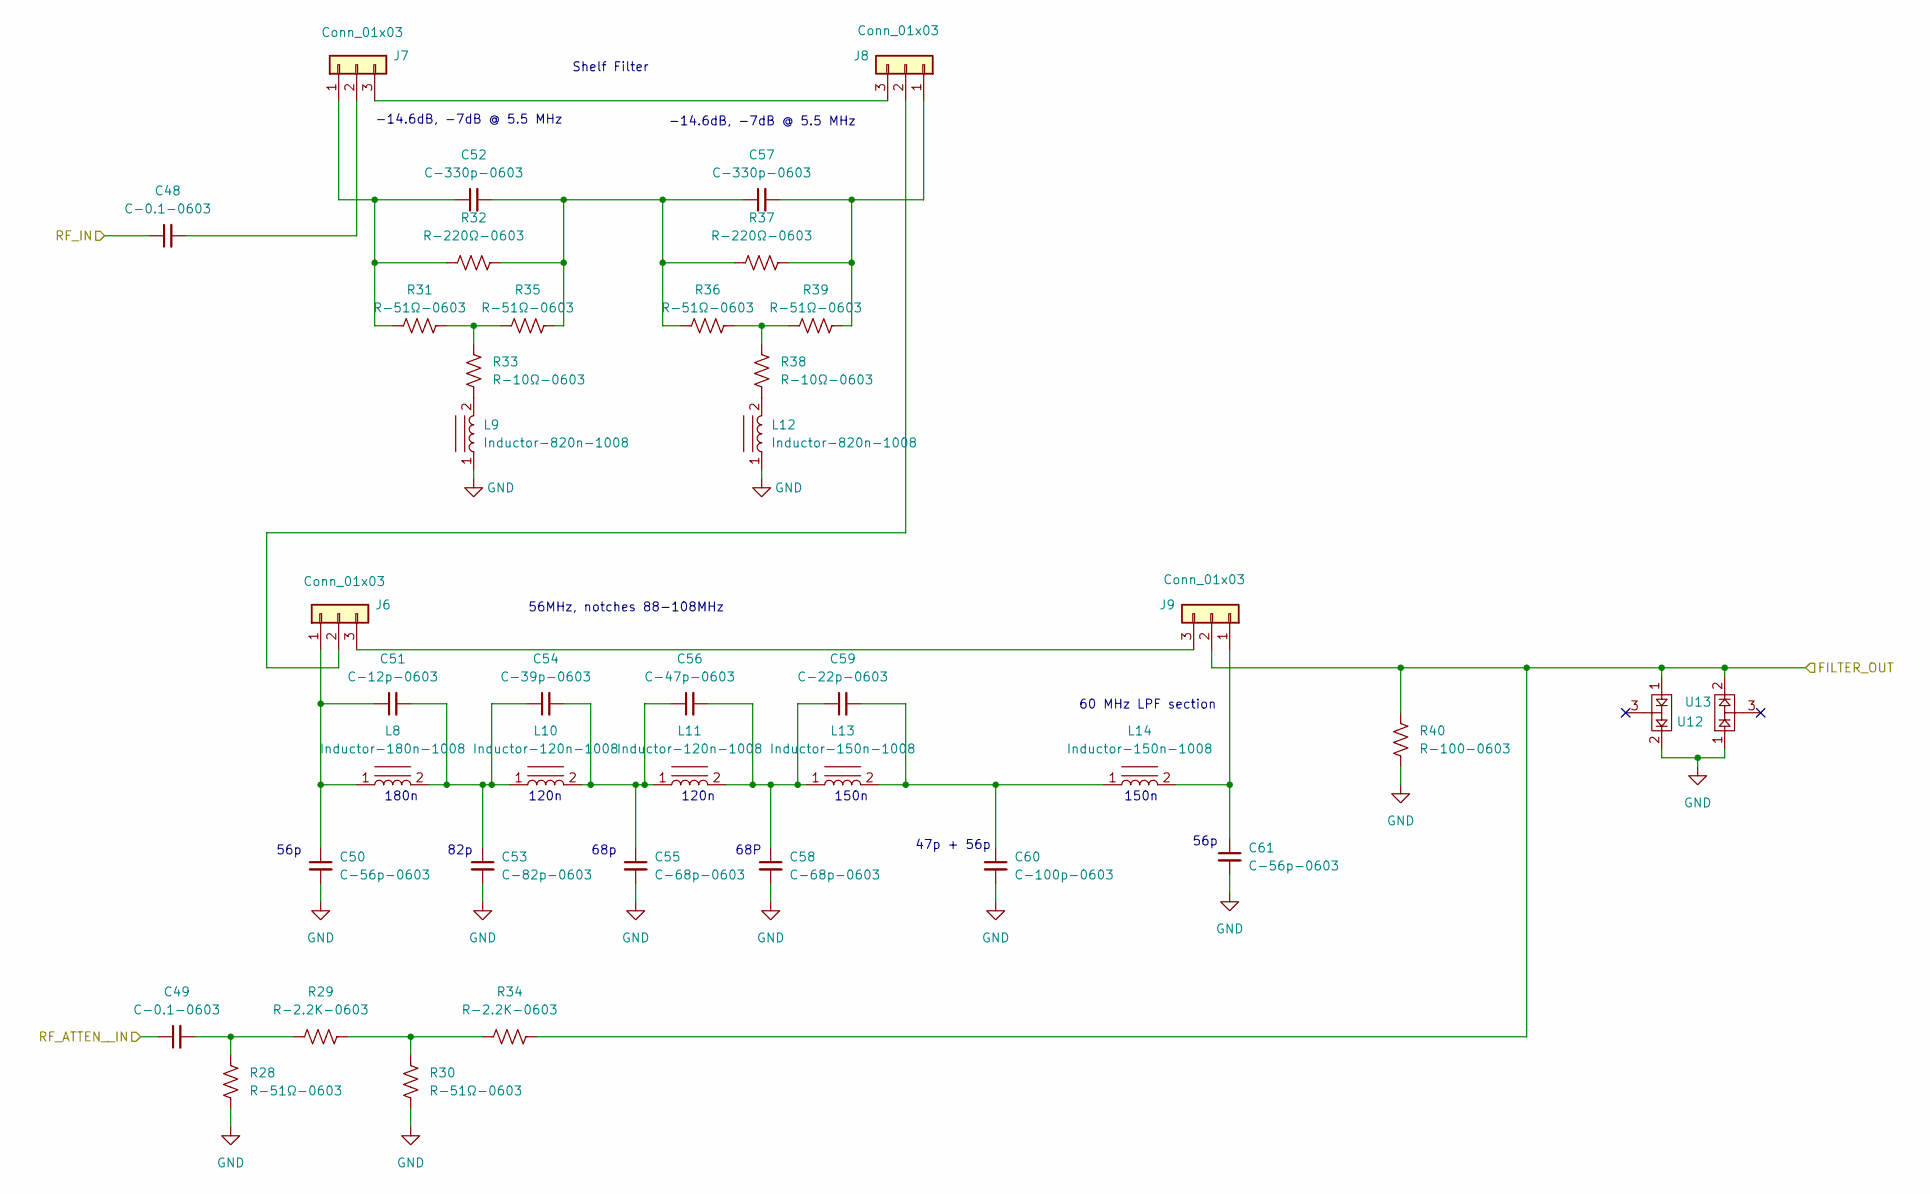
[picture p11: schematic Front_End.kicad_sch]

Parts:
C48, C49: C-0.1-0603; C_0603; LCSC Part # C14663
C50, C61: C-56p-0603; C_0603; LCSC Part # C107053
C51: C-12p-0603; PAD_0603; LCSC Part # C576801
C52, C57: C-330p-0603; PAD_0603; LCSC Part # C327088
C53: C-82p-0603; C_0603; LCSC Part # C1683
C54: C-39p-0603; C_0603; LCSC Part # C107049
C55, C58: C-68p-0603; C_0603; LCSC Part # C62782
C56: C-47p-0603; C_0603; LCSC Part # C105622
C59: C-22p-0603; C_0603; LCSC Part # C105620
C60: C-100p-0603; PAD_0603; LCSC Part # C14665
J6, J7, J8, J9: Conn_01x03; Pin_Header_Straight_1x03_Pitch2.54mm; LCSC Part # C2937625
L8: Inductor-180n-1008; Murata2U; LCSC Part # C162664
L9, L12: Inductor-820n-1008; Murata2U; LCSC Part # C701161
L10, L11: Inductor-120n-1008; Murata2U; LCSC Part # C2044072
L13, L14: Inductor-150n-1008; Murata2U; LCSC Part # C2043109
R28, R30, R31, R35, R36, R39: R-51Ω-0603; PAD_0603; LCSC Part # C23197
R29, R34: R-2.2K-0603; PAD_0603; LCSC Part # C4190
R32, R37: R-220Ω-0603; PAD_0603; LCSC Part # C22962
R33, R38: R-10Ω-0603; PAD_0603; LCSC Part # C22859
R40: R-100-0603; PAD_0603; LCSC Part # C22775
U12, U13: SOT-23; LCSC Part # C78088

Connections:
/Front_End_Filter/FILTER_OUT: J9.2, R34.2, R40.1, U12.1, U13.2; also elsewhere on the board
/Front_End_Filter/RF_ATTEN__IN: C49.1; also elsewhere on the board
/Front_End_Filter/RF_IN: C48.1; also elsewhere on the board
GND: C50.2, C53.2, C55.2, C58.2, C60.2, C61.2, L9.1, L12.1, R28.2, R30.2, R40.2, U12.2, U13.1; also elsewhere on the board
unnamed: C49.2, R28.1, R29.1
unnamed: C51.2, C53.1, C54.1, L8.2, L10.1
unnamed: C52.2, C57.1, R32.2, R35.2, R36.1, R37.1
unnamed: C54.2, C55.1, C56.1, L10.2, L11.1
unnamed: C56.2, C58.1, C59.1, L11.2, L13.1
unnamed: C59.2, C60.1, L13.2, L14.1
unnamed: C50.1, C51.1, J6.1, L8.1
unnamed: J6.2, J8.2
unnamed: J6.3, J9.3
unnamed: C52.1, J7.1, R31.1, R32.1
unnamed: C48.2, J7.2
unnamed: J7.3, J8.3
unnamed: C57.2, J8.1, R37.2, R39.2
unnamed: C61.1, J9.1, L14.2
unnamed: L9.2, R33.2
unnamed: L12.2, R38.2
unnamed: R29.2, R30.1, R34.1
unnamed: R31.2, R33.1, R35.1
unnamed: R36.2, R38.1, R39.1

Notes on the sheet:
82p
47p + 56p
150n
120n
180n
Shelf Filter
56p
68P
68p
-14.6dB, -7dB @ 5.5 MHz
56MHz, notches 88-108MHz
60 MHz LPF section

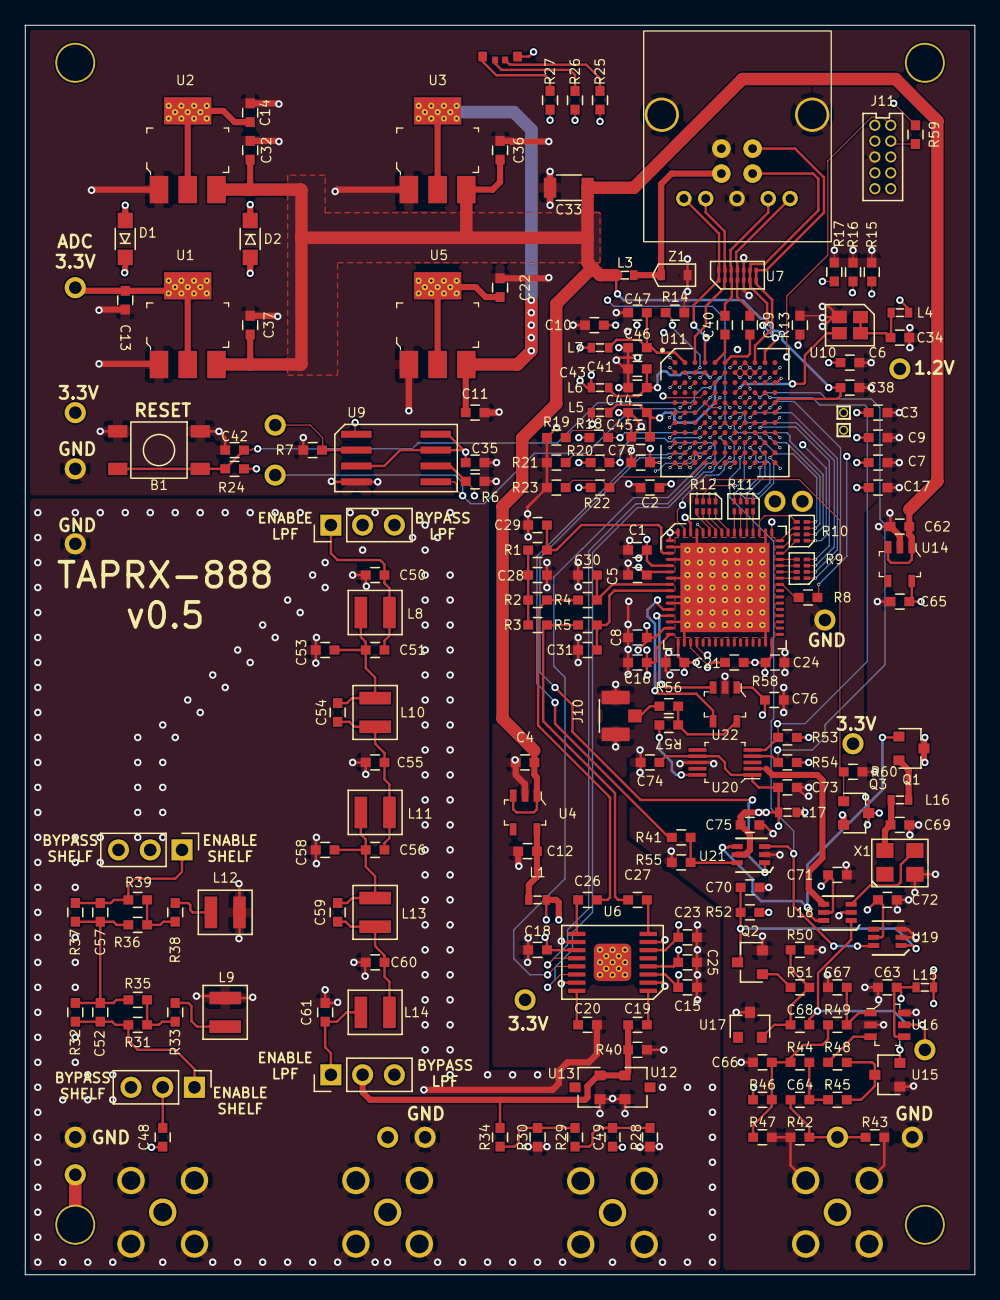
[picture p12: board TAPRX-888.kicad_pcb from above]

Board: 6 copper layers, 76.0 x 100.0 mm, 221 parts (1 on the bottom side), 156 nets.
