ringof/TAPRx888/(commit log)

2026-06-03 Add files via upload
    Schematic and layout fixes per issues 1-11
2026-06-03 split out the KiCad files into their own folder. Please use THIS!
    No need to use a zip file or separate folders for what Git manages already
    [Front_End.kicad_sch, TAPRX-888 v0.3-reannotated.kicad_pcb, TAPRX-888 v0.3-reannotated.kicad_sch, refclk.kicad_sch]
2026-06-03 rename kicad files with version numbers in the names
    not needed
    [TAPRX-888.kicad_pcb, TAPRX-888.kicad_sch]
2026-06-03 add Claude's review of the current work
    Claude's review
2026-06-03 move review from KiCad folder to main folder
    Belongs in the main folder...
2026-06-04 acquire Pauls' latest work
    in zip file 0.3a.zip. took its files and put into TAPRX-888 KiCad, renaming them.
    Moved old work to a new folder, WB6CXC previous work.
    [Front_End.kicad_sch, TAPRX-888.kicad_sch, refclk.kicad_sch]
2026-06-04 Enhance README with additional features
    Added details about SPI boot prom configuration.
2026-06-07 v0.4 changes
    all in a separate folder
    [Front_End.kicad_sch, TAPRX-888.kicad_pcb, TAPRX-888.kicad_sch, refclk.kicad_sch]
2026-06-07 reorg to put into main directory
    moved paul's v0.4 work into the main folder
    [Front_End.kicad_sch, TAPRX-888.kicad_pcb, TAPRX-888.kicad_sch, refclk.kicad_sch]
2026-06-07 Adding local KiCad symbol and footprint libraries to project
    Adding local KiCad symbol and footprint libraries to project
    [Front_End.kicad_sch, TAPRX-888.kicad_sch, refclk.kicad_sch]
2026-06-08 Updated via and relief dimensions
    Dimensions based on JLCPCB documentation, but using 0.15mm hole and 0.25mm clearance minimums.
    [TAPRX-888.kicad_pcb]
2026-06-08 cleanup BGA dimensions
    tighter reliefs under BPA, relaxed elsewhere,
    [TAPRX-888.kicad_pcb]
2026-06-16 add proper si5315 ref manual, augmented BOM
    had to improve the BOM to get the MFG and MPN for each of the 'LCSC part' items. needed for AdvancedPCB to quote. had the si5357 manual, which is not the si5351 manual.
    [bom.csv, updated bom - with MFG and MPN.csv]
2026-06-18 Update README.md formatting and content references
    ask people to look at the TAPRX-888 KiCad folder
2026-06-26 Updated ADC component data, fixed KiCad v10 zone issue
    ADC name and LCSC # updated
    KiCad v10 DRC changes - zone overlap and priority check failed (board OK, just DRC issue). Fixed DRC by merging zones.
    [Front_End.kicad_sch, TAPRX-888.kicad_sch, refclk.kicad_sch]
2026-07-15 Major Update
    Dimensions changed: 100 x 83.5mm
    Edge-mount SMA connectors
    Fixed issues #43 , 45, 32, 31, 26
    Have not added DRC file and properties
    [Front_End.kicad_sch, TAPRX-888 v0.1.kicad_pcb, TAPRX-888 v0.1.kicad_sch, refclk.kicad_sch]
2026-07-15 Added GIT_HASH
    per issue #44
    [TAPRX-888.kicad_pcb]
2026-07-16 Add CLAUDE.md working agreement for the KiCad project
    Adapt the usb3-fiber working-agreement doc for TAPRX-888: project
    overview (HF-only RX-888-based SDR, 6-layer), repository layout with the
    hierarchical schematic under "TAPRX-888 KiCad/", KiCad 10 baseline,
    JLCPCB 6-layer design-rule target, and the intended ERC/DRC CI plus
    kicad-cli command reference.
    Claude-Session: https://claude.ai/code/session_01TgctKPU2xrNUgrBhHoJD15
2026-07-16 Delete v0.1 snapshot; consolidate .gitignore and untrack transient files
    Remove the "TAPRX-888 v0.1/" earlier-snapshot directory (including its
    committed backups and autosave). Fold the KiCad subdirectory .gitignore
    into a single comprehensive root .gitignore covering KiCad backups,
    autosave/temp files, per-user .kicad_prl state, and caches. Untrack the
    committed TAPRX-888.kicad_prl. Drop the v0.1 reference from CLAUDE.md.
    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
    [Front_End.kicad_sch, TAPRX-888 v0.1.kicad_pcb, TAPRX-888 v0.1.kicad_sch, refclk.kicad_sch]
2026-07-16 Flatten KiCad project from subdirectory to repo root
    Move the design, libraries, lib tables, production BOMs, and fab config
    out of "TAPRX-888 KiCad/" to the repo root (history preserved via
    rename). ${KIPRJMOD}-relative lib tables and the hierarchical sheet
    references resolve unchanged. Removes the space-in-path that complicated
    kicad-cli/CI invocation. Update CLAUDE.md layout and command sections to
    match.
    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
    [Front_End.kicad_sch, TAPRX-888.kicad_pcb, TAPRX-888.kicad_sch, bom.csv, refclk.kicad_sch, updated bom - with MFG and MPN.csv]
2026-07-16 Delete stale JLC Parts Details text dump
    The "JLC Parts Details including MFG and MPN.txt" file is a partial,
    human-readable snapshot copy-pasted from the JLCPCB web UI: C/L/U parts
    only (no resistors), missing 3 parts by its own header, and already
    stale (it lists C6364743, which no longer exists in the design). It
    carries no authoritative data not already in the schematic.
    Audit basis: the schematic LCSC Part # fields are internally consistent
    (each value maps to exactly one LCSC and vice-versa) and agree with
    production/bom.csv with zero mismatches across all 194 shared parts. The
    schematic is the source of truth; the BOM is a regenerable export.
    Also document in CLAUDE.md that producti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
2026-07-16 Move reference datasheets to the wiki; point README/CLAUDE.md at it
    Remove the "Reference manuals/" folder (9 device datasheets + RX888
    reference image, ~11 MB) from the code repo now that they are hosted on
    the project wiki. Add wiki pointers in README.md and CLAUDE.md, and fix
    the now-stale README line that referenced the old "TAPRX-888 KiCad/"
    subfolder.
    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
2026-07-16 Remove production/ BOM artifacts; gitignore generated fab outputs
    Delete production/ (bom.csv, the near-duplicate "updated bom" CSV, and
    the 2 MB jlc bom.pdf). These are build products regenerated from the
    schematic via kicad-cli; CI will produce the BOM as an artifact. The
    only non-regenerable data was the hand-added MFG/MPN columns, which are
    derivable from the LCSC part number via the JLC/LCSC catalog.
    Add .gitignore rules for generated fabrication/documentation outputs
    (production/, gerbers/, fab/, *.rpt, *.step) and update the CLAUDE.md
    layout section accordingly.
    Claude-Session: https://claude.ai/code/session_01TgctKPU2xrNUgrBhH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
    [bom.csv, updated bom - with MFG and MPN.csv]
2026-07-16 Attribute original authors in LICENSE (MIT)
    Per MIT's attribution requirement, credit the original authors alongside
    TAPR: Paul Elliott (WB6CXC) of Turn Island Systems, whose Turn Island
    repository is the source of the KiCad design, and George Byrkit (K9TRV),
    who authored the repository's README and BOM/parts documentation.
    Authorship confirmed from git history (design files from
    "Turn Island Systems <paul@turnislandsystems.com>"; README and BOM
    compilation from George Byrkit).
    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
2026-07-16 Remove stale unreferenced board render (TAPRX-888.jpg)
    An old exported board image, not referenced by any tracked file. It is a
    build output, not a design source, so drop it from the repo.
    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
